htarold/logging-pill/pics/2-removed.jpg

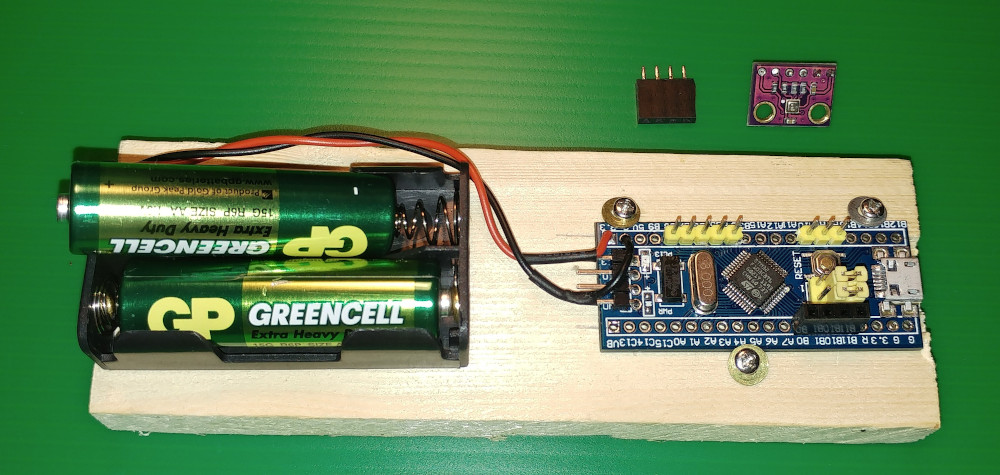
pics/2-removed.jpg
