htarold/logging-pill/src/tx.h

#ifndef TX_H
#define TX_H
/*
  Print to uart0
  XXX For STM32F0 (probably for all Cortex M), string literals
  go in rom anyway.
 */
#include <stdint.h>

#ifdef __AVR__
#include <avr/pgmspace.h>
#define tx_strlit(lit) \
do { static const char s[] PROGMEM = lit; tx_putpgms(s); } while (0)
#else
#define tx_strlit(lit) tx_puts(lit)
#endif

void tx_putc(char ch);
void tx_puts(char * s);
void tx_init(void);
void tx_putdec(int16_t d);
void tx_putdec32(int32_t d);
void tx_puthex(uint8_t x);
void tx_puthex32(uint32_t x);
void tx_puthex64(uint64_t x);
void tx_msg(char * s, int16_t d);
void tx_msg32(char * s, int32_t d);
void tx_msg32x(char * s, uint32_t d);
void tx_putpgms(const char * s);
#define tx_bh() /* nothing */

#endif
