htarold/logging-pill/(commit log)

2020-12-19 Brought up to date with current.
2020-12-20 Power LED need not be removed.
